matheussebastiani/Controlador-de-Temperatura-com-STM32H563zi/sch/esquematico_controle_de_temperatura.pdf

CN8

CN7

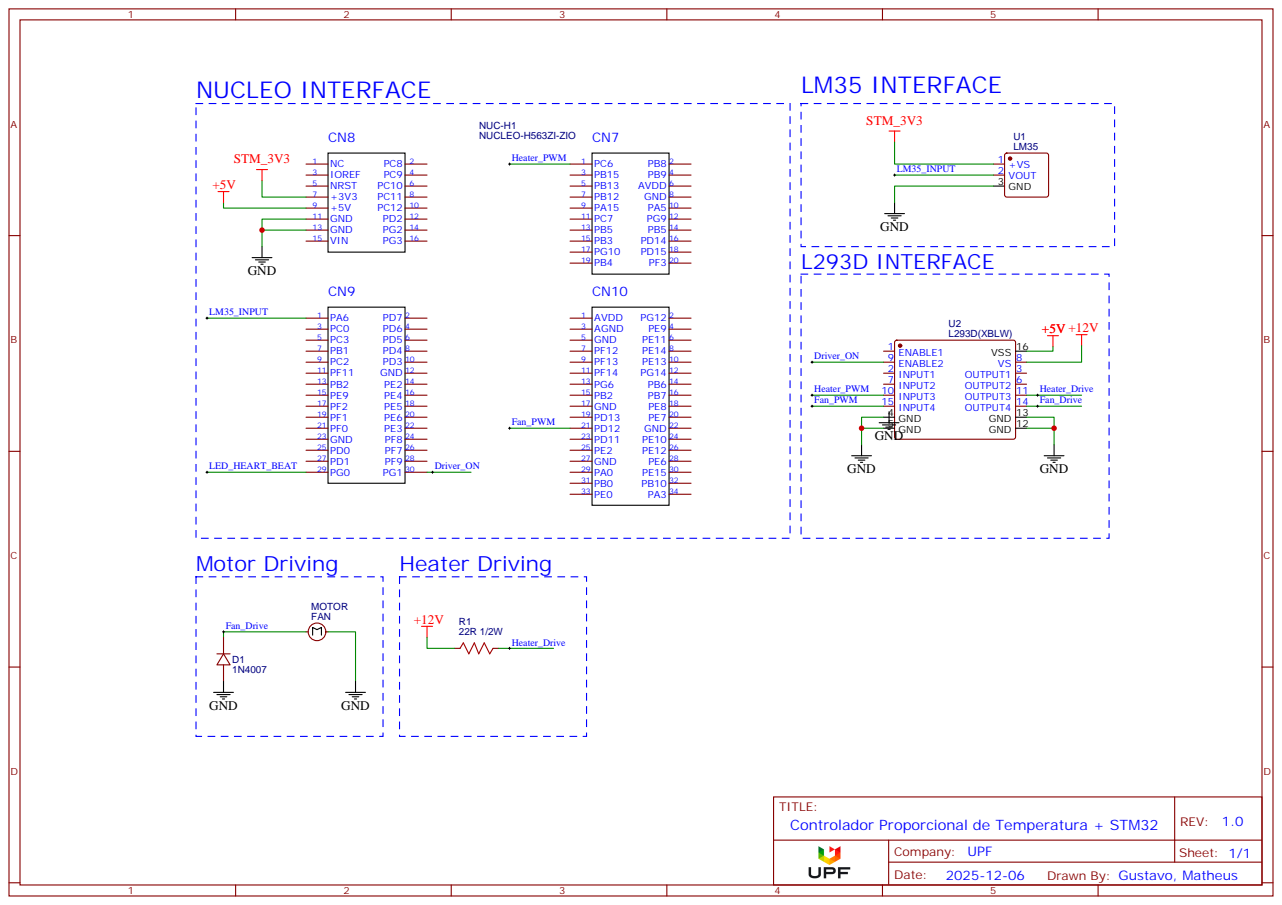
[picture p15: page 1]

Drawn By: Gustavo, Matheus
