matheussebastiani/Controlador-de-Temperatura-com-STM32H563zi/src/Core/Src/main.c

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
/* Includes ------------------------------------------------------------------*/
#include "main.h"
#include "adc.h"
#include "icache.h"
#include "tim.h"
#include "usart.h"
#include "gpio.h"

/* USER CODE BEGIN Includes */
#include "lm35.h"
#include "nextion.h"
#include <stdio.h>
#include <string.h>
#include "pwm.h"
#include "nextion_control_events.h"
#include "control.h"
#include "nextion_interface.h"
#include "nextion_events.h"

/* USER CODE END Includes */


/* USER CODE BEGIN PV */
float duty_cicle;
/* USER CODE END PV */

void SystemClock_Config(void);
/**
  * @brief  The application entry point.
  * @retval int
  */
int main(void)
{

  /* MCU Configuration--------------------------------------------------------*/

  /* Reset of all peripherals, Initializes the Flash interface and the Systick. */
  HAL_Init();

  /* Configure the system clock */
  SystemClock_Config();

  /* Initialize all configured peripherals */
  MX_GPIO_Init();
  MX_ADC1_Init();
  MX_ICACHE_Init();
  MX_USART3_UART_Init();
  MX_TIM3_Init();
  MX_TIM4_Init();
  MX_TIM6_Init();
  /* USER CODE BEGIN 2 */

  HAL_TIM_Base_Start_IT(&htim6);
  nextion_init();
  PWM_Init(&htim3, TIM_CHANNEL_1);
  PWM_Init(&htim4, TIM_CHANNEL_1);
  Nextion_controle_eventos_init();
  event_queue_init(&FilaEventos);
  Nextion_controle_eventos_init();

  /* USER CODE END 2 */

  /* Infinite loop */
  /* USER CODE BEGIN WHILE */
  while (1)
  {
	  Controle_Temperatura();
	  Nextion_controle_eventos_run();
	  Atualiza_PWM();



    /* USER CODE END WHILE */

    /* USER CODE BEGIN 3 */
  }
  /* USER CODE END 3 */
}

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
/* USER CODE BEGIN 4 */

/* Função de callback do TIM6. Será responsável por implementar a lógica do LED de Heart Beat	*/

void HAL_TIM_PeriodElapsedCallback(TIM_HandleTypeDef *htim){

	if(htim-> Instance == TIM6){
		if(InfosControlador.driver_on){
			HAL_GPIO_TogglePin(LED_HEART_BEAT_GPIO_Port, LED_HEART_BEAT_Pin);
		} else {
			HAL_GPIO_WritePin(LED_HEART_BEAT_GPIO_Port, LED_HEART_BEAT_Pin, GPIO_PIN_SET);
		}
	}

}
/* USER CODE END 4 */
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
