matheussebastiani/Controlador-de-Temperatura-com-STM32H563zi/src/Controlador_Temperatura.ioc

Mcu.UserName=STM32H563ZITx
PA6.Signal=ADCx_INP3
PC6.Signal=S_TIM3_CH1
PD12.Signal=S_TIM4_CH1
PD8.Signal=USART3_TX
PD9.Signal=USART3_RX
PG0.GPIO_Label=LED_HEART_BEAT
PG0.Signal=GPIO_Output
