matheussebastiani/Controlador-de-Temperatura-com-STM32H563zi/src/Core/Inc/control.h

/*
 * control.h
 *
 *  Created on: Dec 5, 2025
 *      Author: matheus, gustavo
 */

#ifndef INC_CONTROL_H_
#define INC_CONTROL_H_

void Controle_Temperatura();

void Atualiza_Medidas(); /* Efetua as medições das grandezas necessárias (no momento apenas PV */

void Controle_Modo_Manual();

void Controle_Modo_Automatico();

void Controle_Modo_Segurança();

void Atualiza_PWM();
#endif /* INC_CONTROL_H_ */
