matheussebastiani/Controlador-de-Temperatura-com-STM32H563zi/(commit log)

2025-11-14 adicionado documento de referencia
2025-11-15 adicionado pasta para imagens
2025-11-15 Update README.md
    Adiçao de elementos ao readme
2025-11-15 adicionada descrição do driver l293d
2025-11-22 iniciado o projeto no stm32 + implementação leitura lm35
2025-11-22 pwm INFERNAL funcionando
2025-11-23 coisas que nao commitei ontem
2025-12-01 novo pwm configurado, atualizado readme com explicacao do pwm do resistor
2025-12-01 pwms funcionando
2025-12-03 atualizacoes na gui e criacao do protocolo de mensagem
2025-12-03 descrevendo a máquina de estados NEXTION
2025-12-04 implementado hoje: criação de eventos nextion, fila de eventos nextion, atualizada documentacao
2025-12-04 função de unqueue agora desabilita interrupções para garantir exclusao mutua
2025-12-04 90 por cento da maquidna de estados de controle dos eentos criada
2025-12-05 feat(firmware) implementada lógica de handlers de eventos recebidos do nextion
2025-12-05 refactor(firmware) alteradas as funções de manipulação da fila de eventos
    -Agora enqueue recebe uma cópia do evento
    -Agora dequeue retorna uma cópia do evento desenfileirado
    -A princípio, todas as chamadas das funções foram revisadas
    -REVISA AI LOUÇA
2025-12-05 alterado a programacao e eventos na GUI e debate com colega sobre atualizacoes de valores atrelados com componentes desligados
2025-12-05 atualizacoes na interface e implementacao das funcoes de controle para o mcu com o nextion
2025-12-05 feat(firmware) implementadas pincipais funções de controle
    Atualizando estados importantes a serem checados antes de algum acionamento, mas não efetivamente acionando algo
2025-12-06 atualizacoes no cidgo para a criacao de uma funcao de conrtole geral
2025-12-07 refactor(firmware+ui) removidos trechos de overthinking, removida camada de handle de eventos, tornando-a mais simples
    Alteradas algumas coisas na programação do nextion, detalhes pequenos para intergração com o firmware
2025-12-07 feat(firmware) adicionado funcionalidade do led de heart beat
